Sijankhadk65/orio_dev/orio-jetson/docs/checkerboard_9x6_24mm_a4.pdf

100 mm reference - measure this after printing; if it is not 100 mm, the print was rescaled and every distance will be wrong

Orio stereo calibration target - 10x7 squares = 9x6 inner corners - nominal square 24 mm - print A4 landscape at 100% / actual size, no fit-to-page tools/calibrate_stereo.py
