Sijankhadk65/orio_dev/orio-jetson/grocery-inventory.md

Lay's Classic Potato Chips are $3.49, in aisle 7 with the other snacks, and currently in stock.

Doritos Nacho Cheese chips are $4.29, in aisle 7, and currently in stock.

Pretzel twists are $2.99, in aisle 7, and currently in stock.

Microwave popcorn, a 6-pack, is $3.19, in aisle 7, and currently in stock.

Coca-Cola, a 12-pack of cans, is $5.99, in aisle 7, and currently in stock.

Bottled water, a 24-pack, is $4.49, in aisle 7, and currently in stock.

Orange juice, a half-gallon, is $3.79, in the dairy section in aisle 1, and currently in stock.

Ground coffee, a 12oz bag, is $7.99, in aisle 6 with the other dry goods, and currently in stock.

Whole milk, one gallon, is $3.29, in aisle 1 with the dairy, and currently in stock.

Large eggs, a dozen, are $2.99, in aisle 1 with the dairy, and currently in stock.

Cheddar cheese, an 8oz block, is $4.49, in aisle 1 with the dairy, and currently in stock.

Butter, a 1lb pack, is $4.99, in aisle 1 with the dairy, and currently in stock.

Bananas are $0.59 a pound, in the produce section near the entrance, and currently in stock.

Apples are $1.29 a pound, in the produce section near the entrance, and currently in stock.

Tomatoes are $1.99 a pound, in the produce section near the entrance, and currently in stock.

Avocados are $1.49 each, in the produce section near the entrance, and currently in stock.

White sandwich bread is $2.49 a loaf, in the bakery section at the front of the store, and currently in stock.

Bagels, a 6-pack, are $3.99, in the bakery section at the front of the store, and currently in stock.

Croissants, a 6-pack, are $4.29, in the bakery section at the front of the store, and currently in stock.

Canned corn is $0.99 a can, in aisle 4 with the other canned goods, and currently in stock.

Tomato soup is $1.29 a can, in aisle 4 with the other canned goods, and currently in stock.

Black beans are $1.09 a can, in aisle 4 with the other canned goods, and currently in stock.

Paper towels, a 6-roll pack, are $6.99, in aisle 8 with household supplies, and currently in stock.

Dish soap is $3.49 a bottle, in aisle 8 with household supplies, and currently in stock.

Laundry detergent is $9.99 a bottle, in aisle 8 with household supplies, and currently in stock.

Frozen pizza is $5.99 each, in aisle 2 with the frozen foods, and currently in stock.

Ice cream, a 1-quart tub, is $4.99, in aisle 2 with the frozen foods, and currently in stock.

Frozen mixed vegetables, a 1lb bag, are $2.49, in aisle 3 with the frozen foods, and currently in stock.

Rice, a 5lb bag, is $6.49, in aisle 5 with the other dry goods, and currently in stock.

Pasta, a 1lb box, is $1.79, in aisle 5 with the other dry goods, and currently in stock.
