Sijankhadk65/orio_dev/hardware/orio-carrier/conv7v4.kicad_sch

## KiCad design hardware/orio-carrier/conv7v4.kicad_sch (2026-09-13, an earlier design)

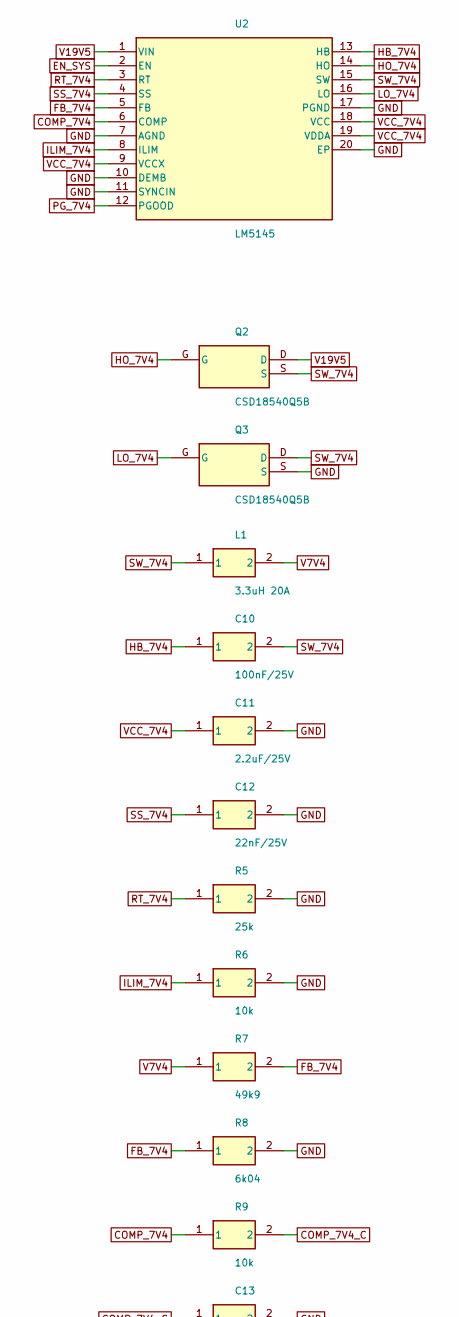
[picture p1: schematic conv7v4.kicad_sch, part in row 1, column 1]

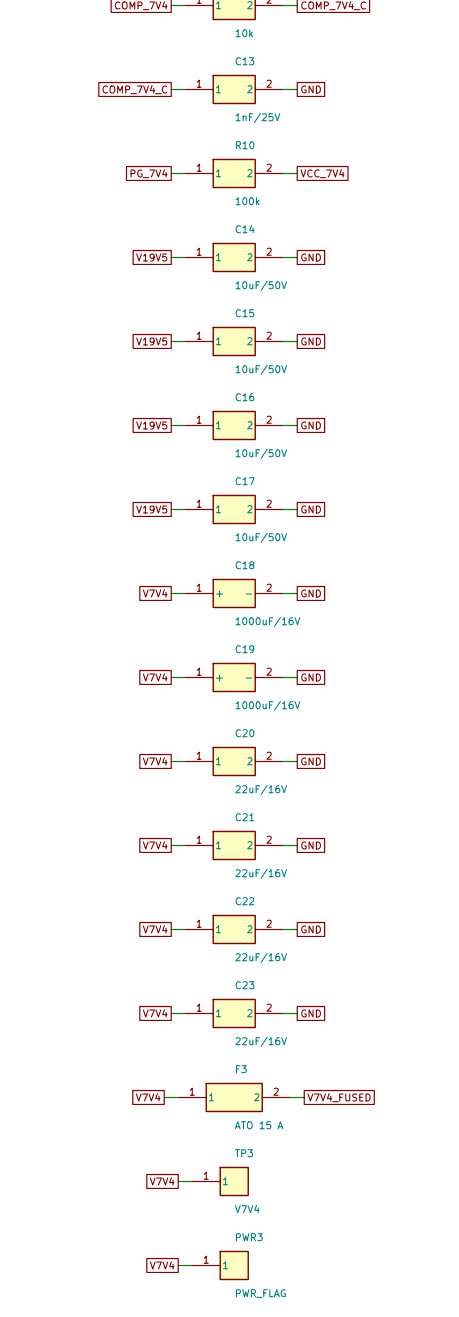
[picture p2: schematic conv7v4.kicad_sch, part in row 2, column 1]

Parts:
C10: 100nF/25V; C_0805_2012Metric
C11: 2.2uF/25V; C_0805_2012Metric
C12: 22nF/25V; C_0805_2012Metric
C13: 1nF/25V; C_0805_2012Metric
C14, C15, C16, C17: 10uF/50V; C_1210_3225Metric
C18, C19: 1000uF/16V; CP_Radial_D12.5mm_P5.00mm
C20, C21, C22, C23: 22uF/16V; C_1210_3225Metric
F3: ATO 15 A; PinHeader_1x02_P2.54mm_Vertical
L1: 3.3uH 20A; L_Bourns_SRP1265A
PWR3: PWR_FLAG
Q2, Q3: CSD18540Q5B; TO-263-2
R5: 25k; R_0805_2012Metric
R6, R9: 10k; R_0805_2012Metric
R7: 49k9; R_0805_2012Metric
R8: 6k04; R_0805_2012Metric
R10: 100k; R_0805_2012Metric
TP3: V7V4; TestPoint_Pad_D2.0mm
U2: LM5145; VQFN-24-1EP_4x4mm_P0.5mm_EP2.6x2.6mm

Connections:
COMP_7V4: R9.1, U2.6 (COMP)
COMP_7V4_C: C13.1, R9.2
EN_SYS: U2.2 (EN)
FB_7V4: R7.2, R8.1, U2.5 (FB)
GND: C11.2, C12.2, C13.2, C14.2, C15.2, C16.2, C17.2, C18.2 (-), C19.2 (-), C20.2, C21.2, C22.2, C23.2, Q3.S, R5.2, R6.2, R8.2, U2.7 (AGND), U2.10 (DEMB), U2.11 (SYNCIN), U2.17 (PGND), U2.20 (EP)
HB_7V4: C10.1, U2.13 (HB)
HO_7V4: Q2.G, U2.14 (HO)
ILIM_7V4: R6.1, U2.8 (ILIM)
LO_7V4: Q3.G, U2.16 (LO)
PG_7V4: R10.1, U2.12 (PGOOD)
RT_7V4: R5.1, U2.3 (RT)
SS_7V4: C12.1, U2.4 (SS)
SW_7V4: C10.2, L1.1, Q2.S, Q3.D, U2.15 (SW)
V7V4: C18.1 (+), C19.1 (+), C20.1, C21.1, C22.1, C23.1, F3.1, L1.2, PWR3.1, R7.1, TP3.1
V7V4_FUSED: F3.2
V19V5: C14.1, C15.1, C16.1, C17.1, Q2.D, U2.1 (VIN)
VCC_7V4: C11.1, R10.2, U2.9 (VCCX), U2.18 (VCC), U2.19 (VDDA)
