Sijankhadk65/orio_dev/hardware/orio-carrier/conv12_5.kicad_sch

## KiCad design hardware/orio-carrier/conv12_5.kicad_sch (2026-09-13, an earlier design)

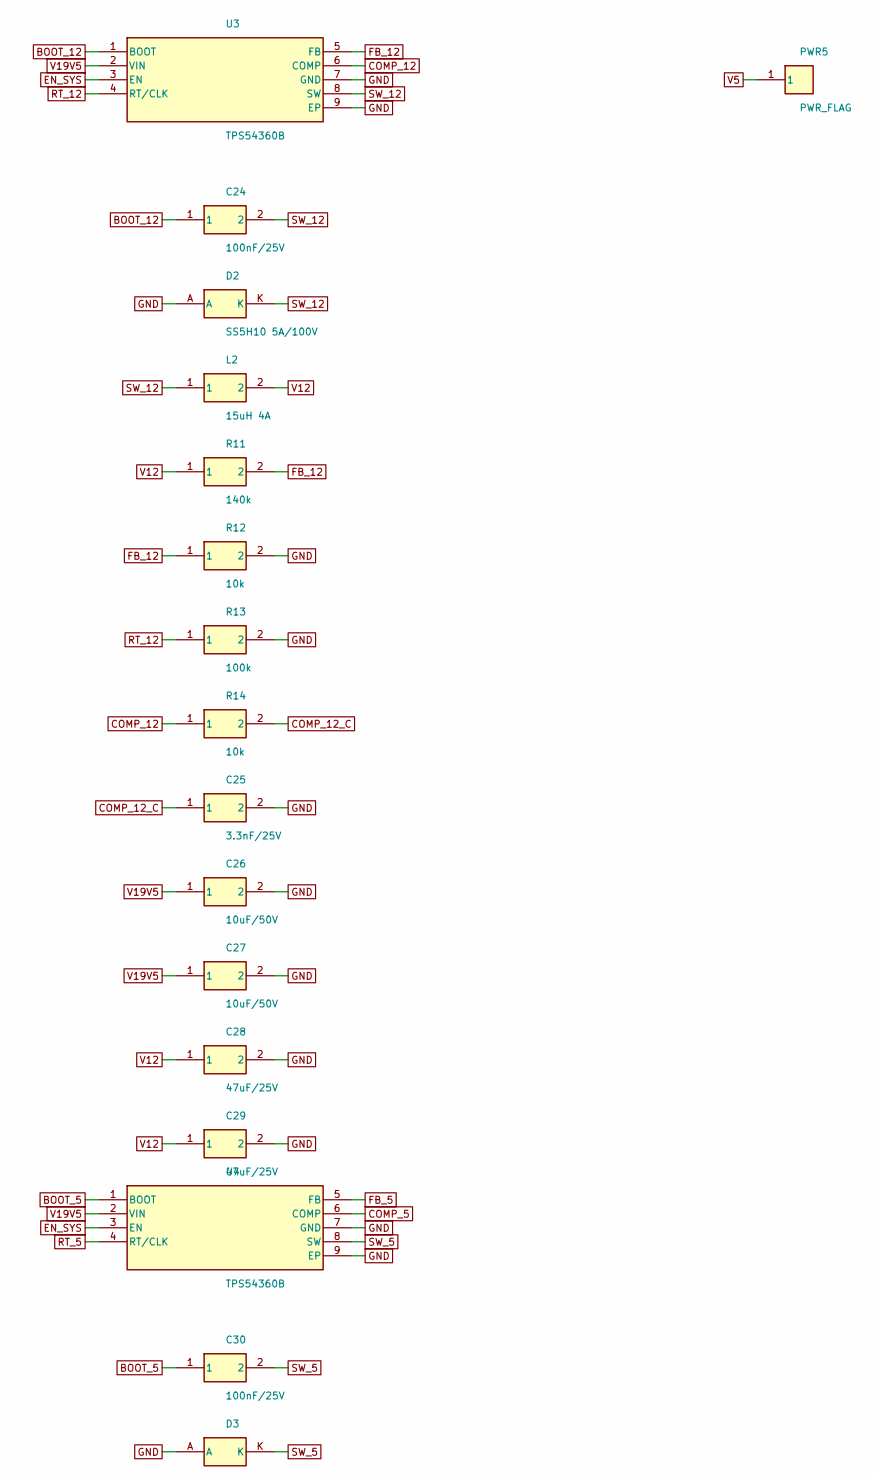
[picture p3: schematic conv12_5.kicad_sch, part in row 1, column 1]

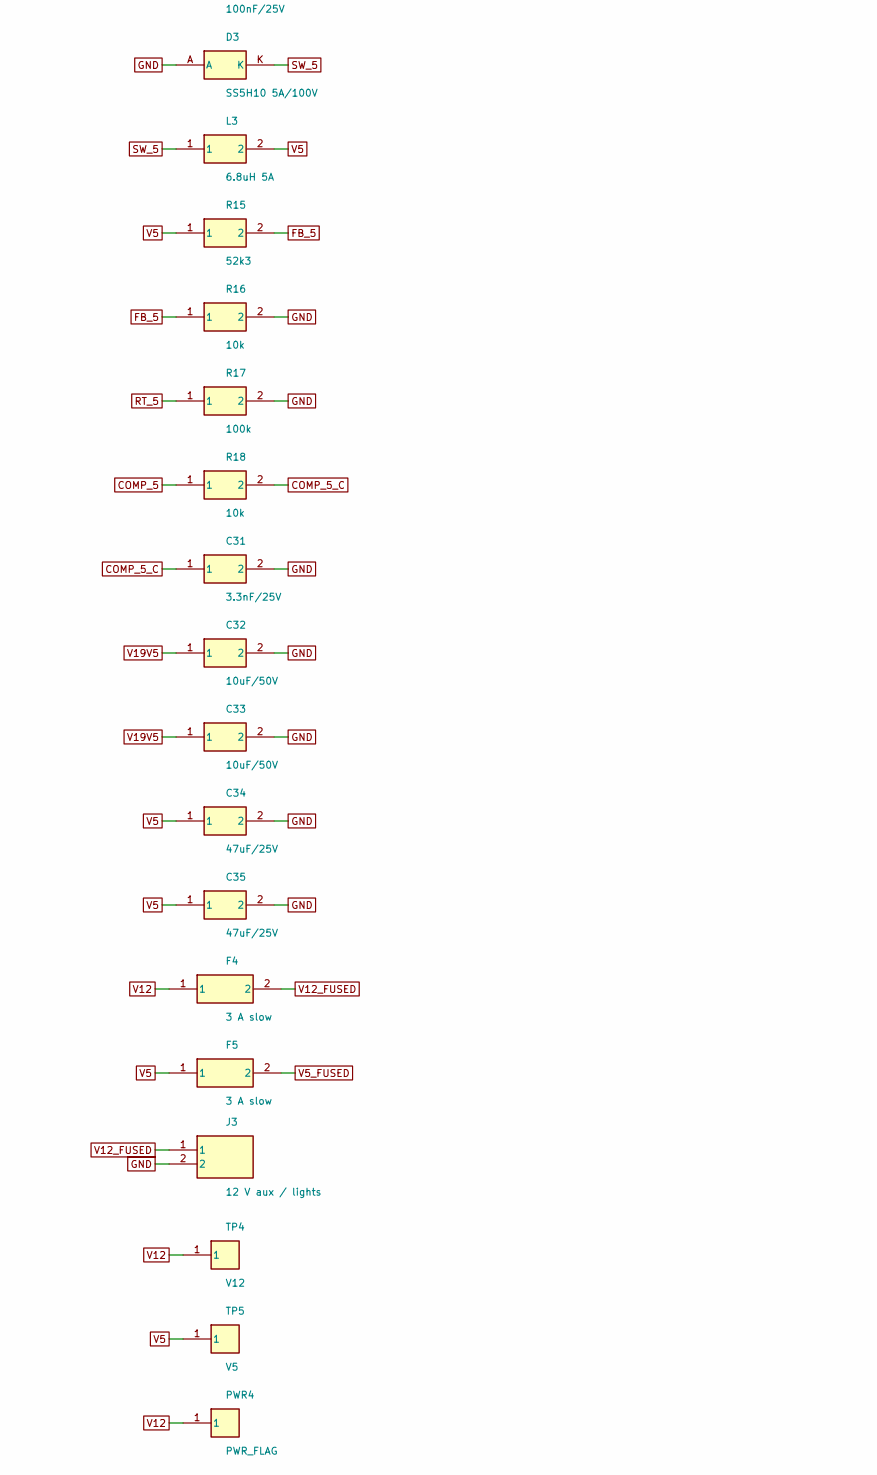
[picture p4: schematic conv12_5.kicad_sch, part in row 2, column 1]

Parts:
C24, C30: 100nF/25V; C_0805_2012Metric
C25, C31: 3.3nF/25V; C_0805_2012Metric
C26, C27, C32, C33: 10uF/50V; C_1210_3225Metric
C28, C29, C34, C35: 47uF/25V; C_1210_3225Metric
D2, D3: SS5H10 5A/100V; D_SMC
F4, F5: 3 A slow; Fuse_1812_4532Metric
J3: 12 V aux / lights; TerminalBlock_Phoenix_MKDS-1,5-2_1x02_P5.00mm_Horizontal
L2: 15uH 4A; L_Bourns-SRN6045TA
L3: 6.8uH 5A; L_Bourns-SRN6045TA
PWR4, PWR5: PWR_FLAG
R11: 140k; R_0805_2012Metric
R12, R14, R16, R18: 10k; R_0805_2012Metric
R13, R17: 100k; R_0805_2012Metric
R15: 52k3; R_0805_2012Metric
TP4: V12; TestPoint_Pad_D2.0mm
TP5: V5; TestPoint_Pad_D2.0mm
U3, U4: TPS54360B; SOIC-8-1EP_3.9x4.9mm_P1.27mm_EP2.29x3.0mm

Connections:
BOOT_5: C30.1, U4.1 (BOOT)
BOOT_12: C24.1, U3.1 (BOOT)
COMP_5: R18.1, U4.6 (COMP)
COMP_5_C: C31.1, R18.2
COMP_12: R14.1, U3.6 (COMP)
COMP_12_C: C25.1, R14.2
EN_SYS: U3.3 (EN), U4.3 (EN)
FB_5: R15.2, R16.1, U4.5 (FB)
FB_12: R11.2, R12.1, U3.5 (FB)
GND: C25.2, C26.2, C27.2, C28.2, C29.2, C31.2, C32.2, C33.2, C34.2, C35.2, D2.A, D3.A, J3.2, R12.2, R13.2, R16.2, R17.2, U3.7 (GND), U3.9 (EP), U4.7 (GND), U4.9 (EP)
RT_5: R17.1, U4.4 (RT/CLK)
RT_12: R13.1, U3.4 (RT/CLK)
SW_5: C30.2, D3.K, L3.1, U4.8 (SW)
SW_12: C24.2, D2.K, L2.1, U3.8 (SW)
V5: C34.1, C35.1, F5.1, L3.2, PWR5.1, R15.1, TP5.1
V5_FUSED: F5.2
V12: C28.1, C29.1, F4.1, L2.2, PWR4.1, R11.1, TP4.1
V12_FUSED: F4.2, J3.1
V19V5: C26.1, C27.1, C32.1, C33.1, U3.2 (VIN), U4.2 (VIN)
