Sijankhadk65/orio_dev/hardware/orio-carrier/drivetrain.kicad_sch

## KiCad design hardware/orio-carrier/drivetrain.kicad_sch (2026-09-13, an earlier design)

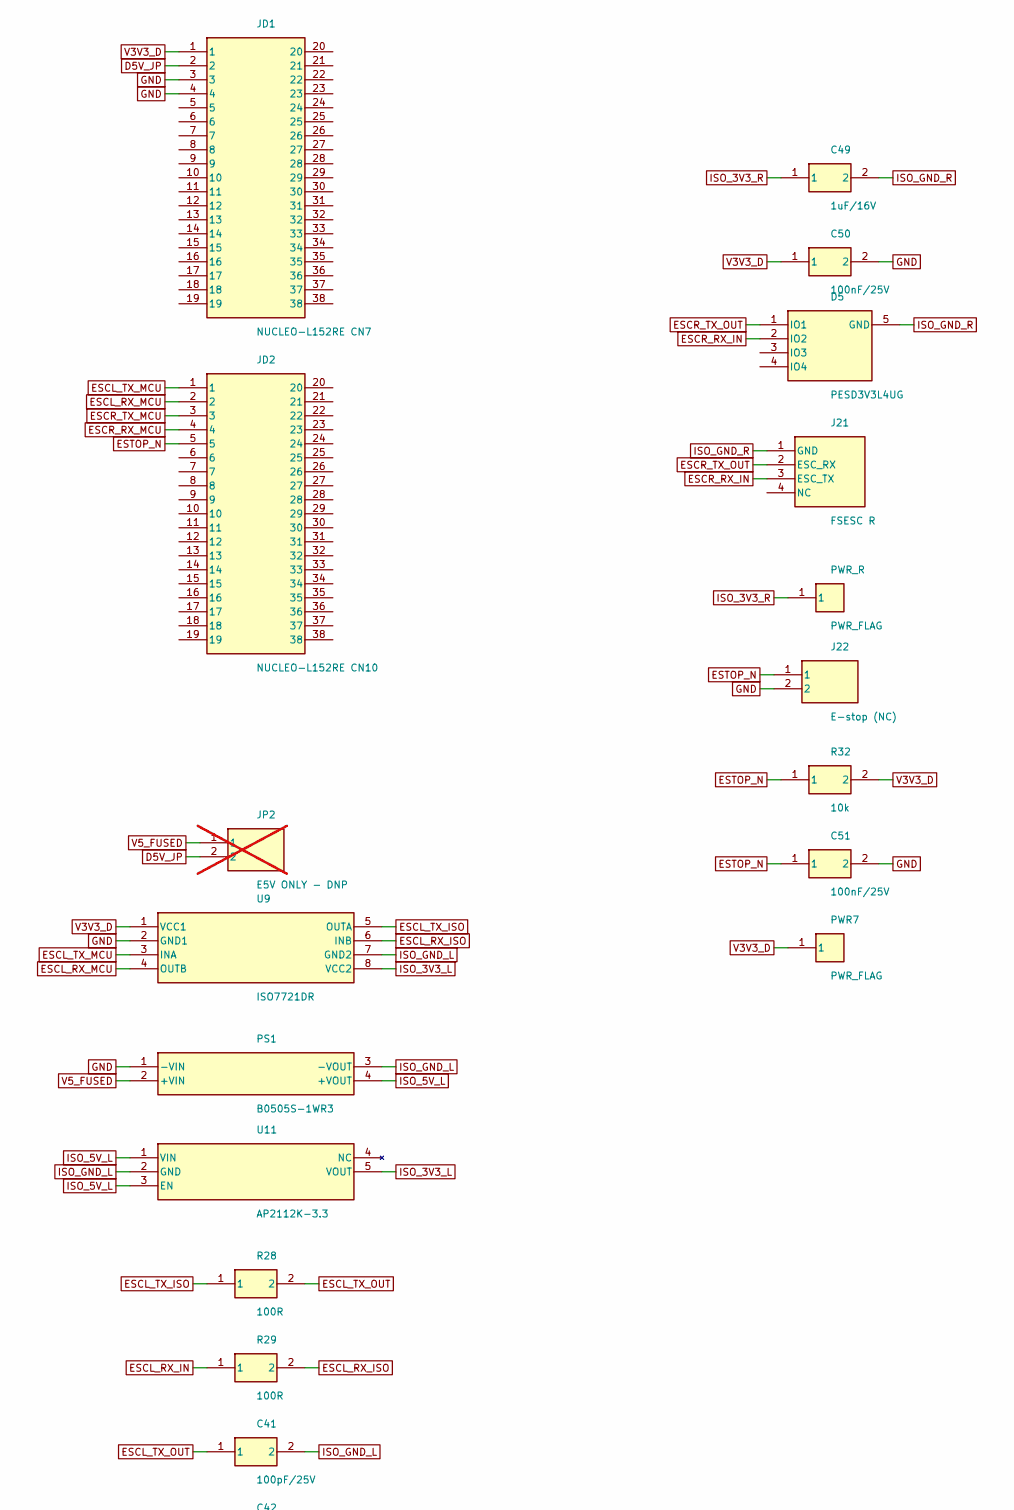
[picture p5: schematic drivetrain.kicad_sch, part in row 1, column 1]

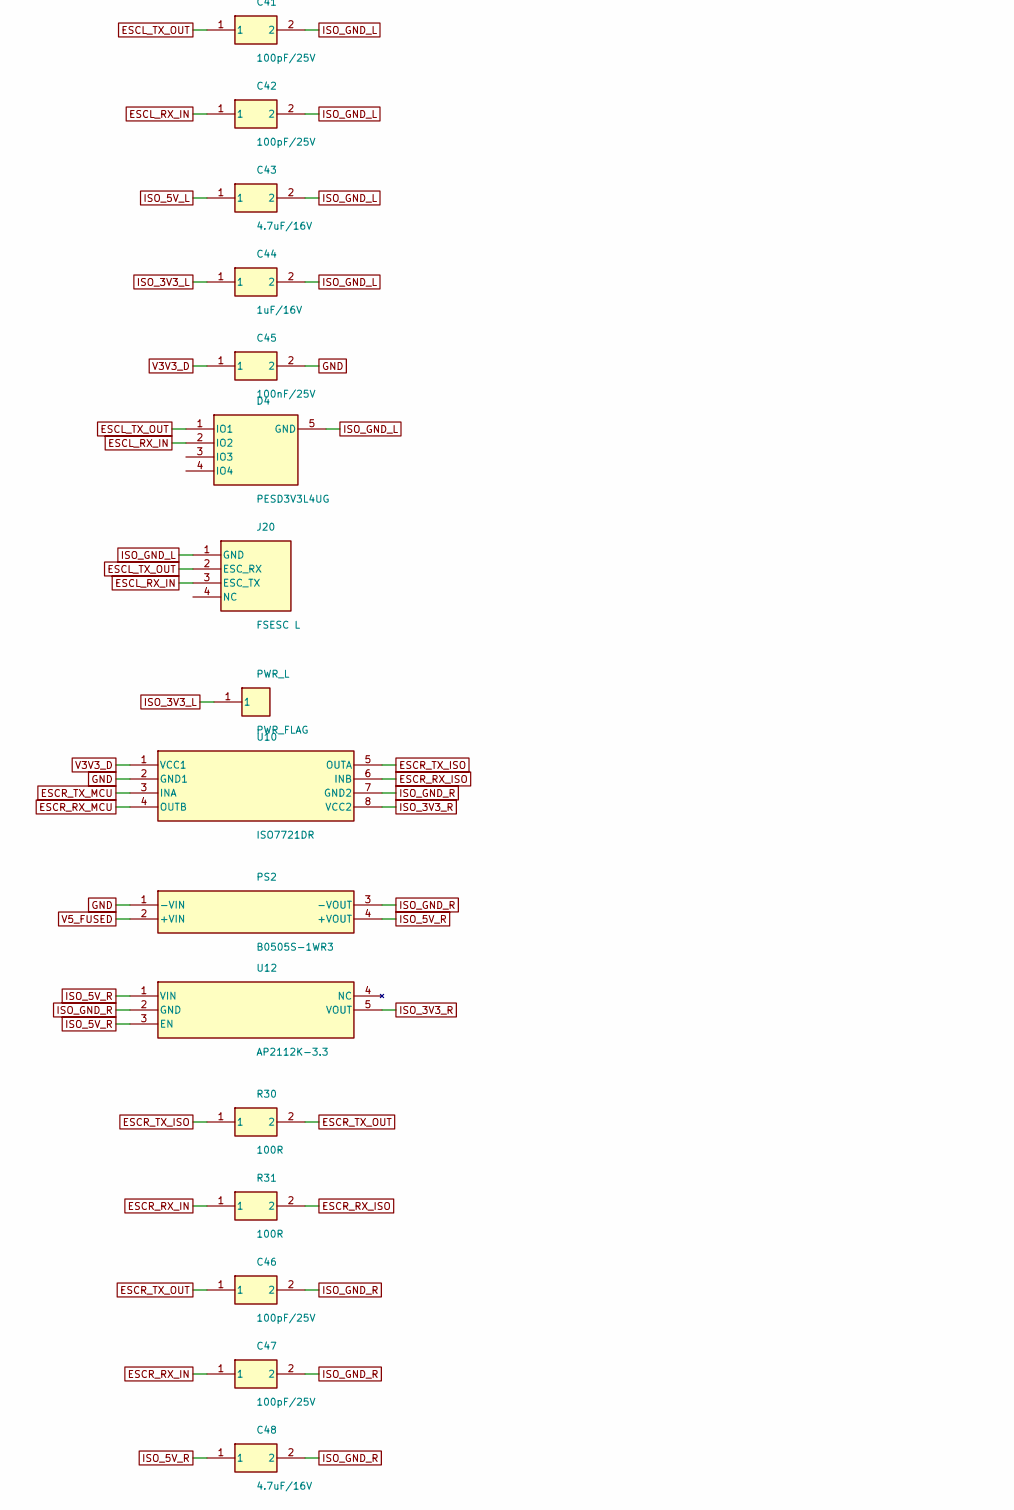
[picture p6: schematic drivetrain.kicad_sch, part in row 2, column 1]

Parts:
C41, C42, C46, C47: 100pF/25V; C_0805_2012Metric
C43, C48: 4.7uF/16V; C_0805_2012Metric
C44, C49: 1uF/16V; C_0805_2012Metric
C45, C50, C51: 100nF/25V; C_0805_2012Metric
D4, D5: PESD3V3L4UG; SOT-23-6
J20: FSESC L; JST_XH_B4B-XH-A_1x04_P2.50mm_Vertical
J21: FSESC R; JST_XH_B4B-XH-A_1x04_P2.50mm_Vertical
J22: E-stop (NC); PinHeader_1x02_P2.54mm_Vertical
JD1: NUCLEO-L152RE CN7; PinSocket_2x19_P2.54mm_Vertical
JD2: NUCLEO-L152RE CN10; PinSocket_2x19_P2.54mm_Vertical
JP2: E5V ONLY - DNP; PinHeader_1x02_P2.54mm_Vertical; not fitted
PS1, PS2: B0505S-1WR3; Converter_DCDC_MORNSUN_B0505S-1WR3_SIP
PWR7: PWR_FLAG
PWR_L: PWR_FLAG
PWR_R: PWR_FLAG
R28, R29, R30, R31: 100R; R_0805_2012Metric
R32: 10k; R_0805_2012Metric
U9, U10: ISO7721DR; SOIC-8_3.9x4.9mm_P1.27mm
U11, U12: AP2112K-3.3; SOT-23-5

Connections:
D5V_JP: JD1.2, JP2.2
ESCL_RX_IN: C42.1, D4.2 (IO2), J20.3 (ESC_TX), R29.1
ESCL_RX_ISO: R29.2, U9.6 (INB)
ESCL_RX_MCU: JD2.2, U9.4 (OUTB)
ESCL_TX_ISO: R28.1, U9.5 (OUTA)
ESCL_TX_MCU: JD2.1, U9.3 (INA)
ESCL_TX_OUT: C41.1, D4.1 (IO1), J20.2 (ESC_RX), R28.2
ESCR_RX_IN: C47.1, D5.2 (IO2), J21.3 (ESC_TX), R31.1
ESCR_RX_ISO: R31.2, U10.6 (INB)
ESCR_RX_MCU: JD2.4, U10.4 (OUTB)
ESCR_TX_ISO: R30.1, U10.5 (OUTA)
ESCR_TX_MCU: JD2.3, U10.3 (INA)
ESCR_TX_OUT: C46.1, D5.1 (IO1), J21.2 (ESC_RX), R30.2
ESTOP_N: C51.1, J22.1, JD2.5, R32.1
GND: C45.2, C50.2, C51.2, J22.2, JD1.3, JD1.4, PS1.1 (-VIN), PS2.1 (-VIN), U9.2 (GND1), U10.2 (GND1)
ISO_3V3_L: C44.1, PWR_L.1, U9.8 (VCC2), U11.5 (VOUT)
ISO_3V3_R: C49.1, PWR_R.1, U10.8 (VCC2), U12.5 (VOUT)
ISO_5V_L: C43.1, PS1.4 (+VOUT), U11.1 (VIN), U11.3 (EN)
ISO_5V_R: C48.1, PS2.4 (+VOUT), U12.1 (VIN), U12.3 (EN)
ISO_GND_L: C41.2, C42.2, C43.2, C44.2, D4.5 (GND), J20.1 (GND), PS1.3 (-VOUT), U9.7 (GND2), U11.2 (GND)
ISO_GND_R: C46.2, C47.2, C48.2, C49.2, D5.5 (GND), J21.1 (GND), PS2.3 (-VOUT), U10.7 (GND2), U12.2 (GND)
V3V3_D: C45.1, C50.1, JD1.1, PWR7.1, R32.2, U9.1 (VCC1), U10.1 (VCC1)
V5_FUSED: JP2.1, PS1.2 (+VIN), PS2.2 (+VIN)
