Sijankhadk65/orio_dev/hardware/orio-carrier/motion.kicad_sch

## KiCad design hardware/orio-carrier/motion.kicad_sch (2026-09-13)

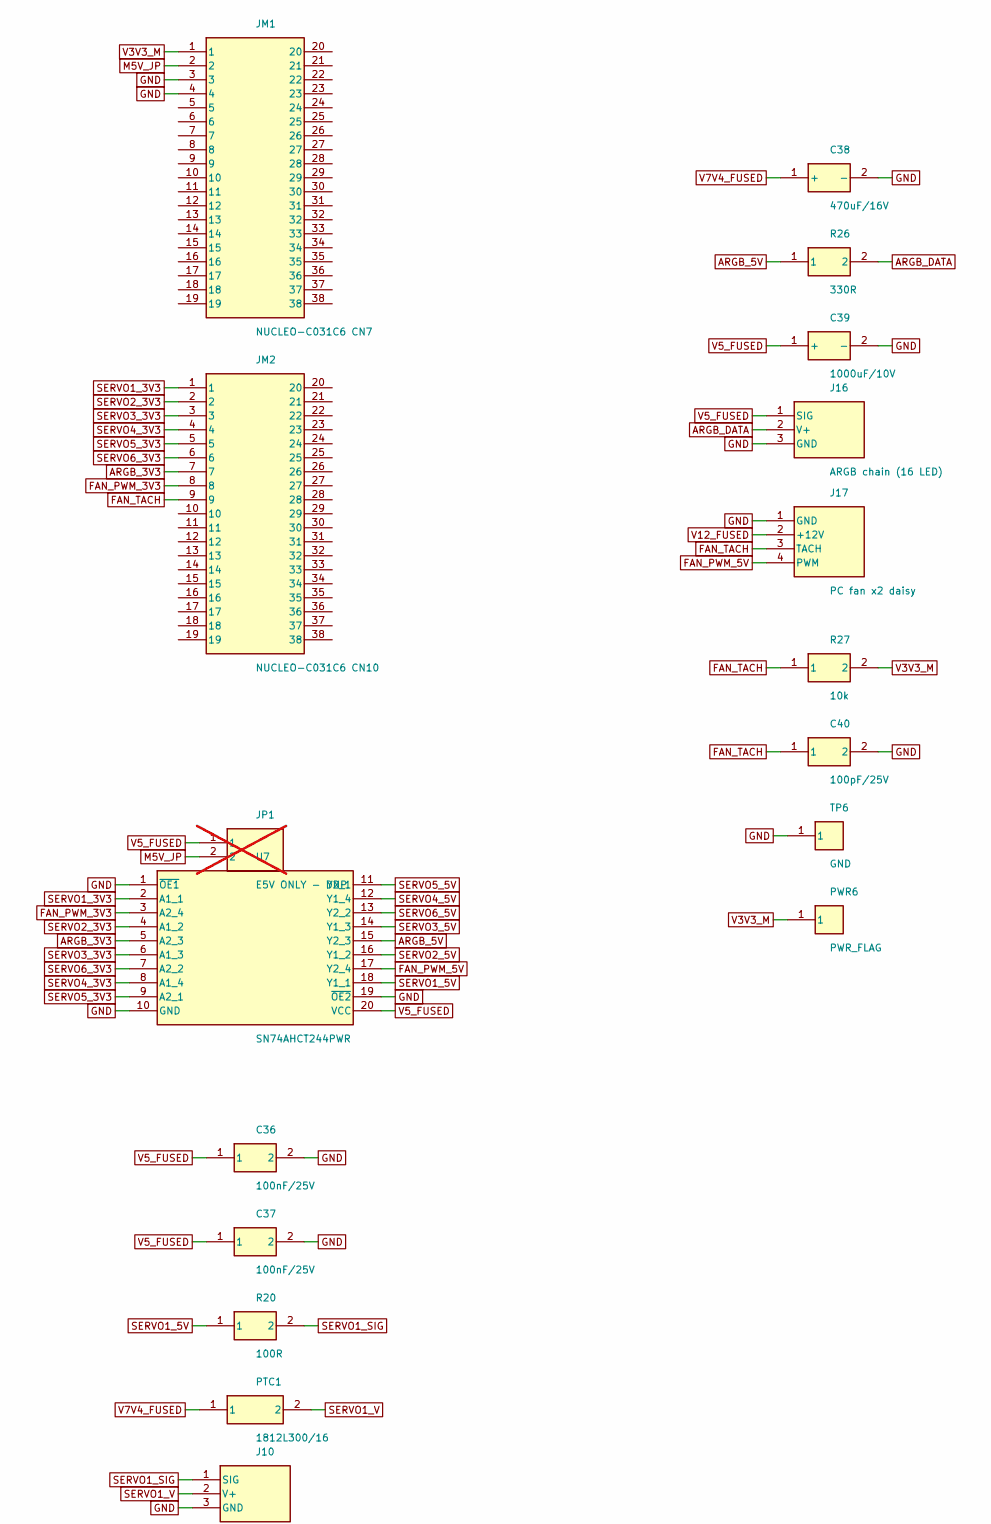
[picture p7: schematic motion.kicad_sch, part in row 1, column 1]

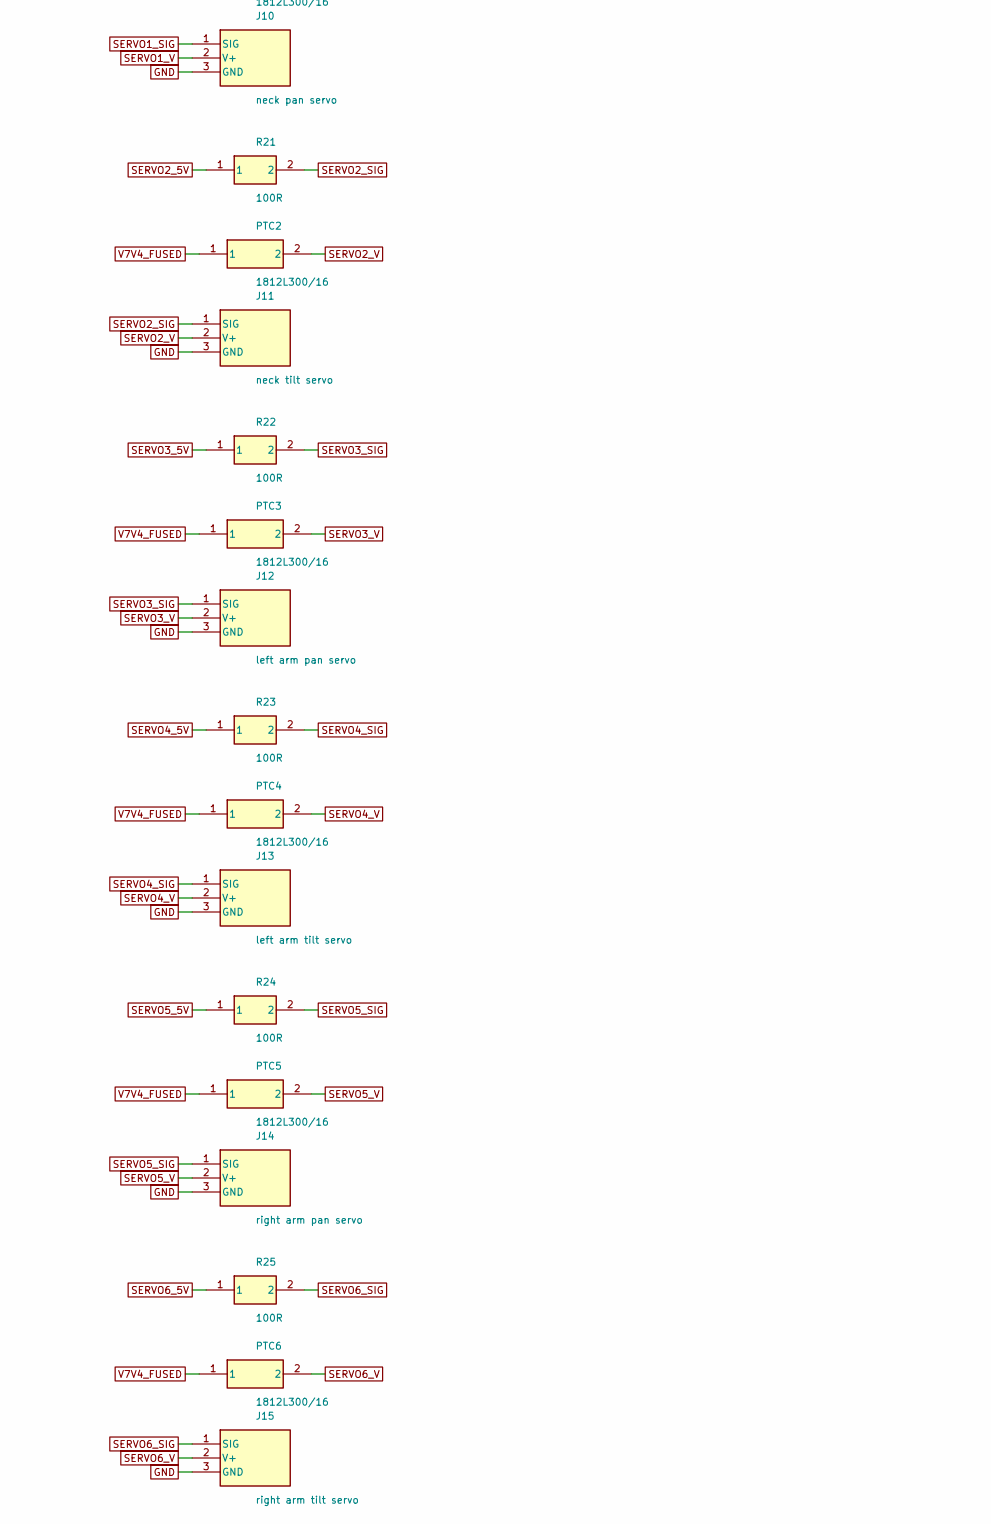
[picture p8: schematic motion.kicad_sch, part in row 2, column 1]

Parts:
C36, C37: 100nF/25V; C_0805_2012Metric
C38: 470uF/16V; CP_Radial_D10.0mm_P5.00mm
C39: 1000uF/10V; CP_Radial_D12.5mm_P5.00mm
C40: 100pF/25V; C_0805_2012Metric
J10: neck pan servo; PinHeader_1x03_P2.54mm_Vertical
J11: neck tilt servo; PinHeader_1x03_P2.54mm_Vertical
J12: left arm pan servo; PinHeader_1x03_P2.54mm_Vertical
J13: left arm tilt servo; PinHeader_1x03_P2.54mm_Vertical
J14: right arm pan servo; PinHeader_1x03_P2.54mm_Vertical
J15: right arm tilt servo; PinHeader_1x03_P2.54mm_Vertical
J16: ARGB chain (16 LED); PinHeader_1x03_P2.54mm_Vertical
J17: PC fan x2 daisy; PinHeader_1x04_P2.54mm_Vertical
JM1: NUCLEO-C031C6 CN7; PinSocket_2x19_P2.54mm_Vertical
JM2: NUCLEO-C031C6 CN10; PinSocket_2x19_P2.54mm_Vertical
JP1: E5V ONLY - DNP; PinHeader_1x02_P2.54mm_Vertical; not fitted
PTC1, PTC2, PTC3, PTC4, PTC5, PTC6: 1812L300/16; R_1812_4532Metric
PWR6: PWR_FLAG
R20, R21, R22, R23, R24, R25: 100R; R_0805_2012Metric
R26: 330R; R_0805_2012Metric
R27: 10k; R_0805_2012Metric
TP6: GND; TestPoint_Pad_D2.0mm
U7: SN74AHCT244PWR; TSSOP-20_4.4x6.5mm_P0.65mm

Connections:
ARGB_3V3: JM2.7, U7.5 (A2_3)
ARGB_5V: R26.1, U7.15 (Y2_3)
ARGB_DATA: J16.2 (V+), R26.2
FAN_PWM_3V3: JM2.8, U7.3 (A2_4)
FAN_PWM_5V: J17.4 (PWM), U7.17 (Y2_4)
FAN_TACH: C40.1, J17.3 (TACH), JM2.9, R27.1
GND: C36.2, C37.2, C38.2 (-), C39.2 (-), C40.2, J10.3 (GND), J11.3 (GND), J12.3 (GND), J13.3 (GND), J14.3 (GND), J15.3 (GND), J16.3 (GND), J17.1 (GND), JM1.3, JM1.4, TP6.1, U7.1 (~OE1), U7.10 (GND), U7.19 (~OE2)
M5V_JP: JM1.2, JP1.2
SERVO1_3V3: JM2.1, U7.2 (A1_1)
SERVO1_5V: R20.1, U7.18 (Y1_1)
SERVO1_SIG: J10.1 (SIG), R20.2
SERVO1_V: J10.2 (V+), PTC1.2
SERVO2_3V3: JM2.2, U7.4 (A1_2)
SERVO2_5V: R21.1, U7.16 (Y1_2)
SERVO2_SIG: J11.1 (SIG), R21.2
SERVO2_V: J11.2 (V+), PTC2.2
SERVO3_3V3: JM2.3, U7.6 (A1_3)
SERVO3_5V: R22.1, U7.14 (Y1_3)
SERVO3_SIG: J12.1 (SIG), R22.2
SERVO3_V: J12.2 (V+), PTC3.2
SERVO4_3V3: JM2.4, U7.8 (A1_4)
SERVO4_5V: R23.1, U7.12 (Y1_4)
SERVO4_SIG: J13.1 (SIG), R23.2
SERVO4_V: J13.2 (V+), PTC4.2
SERVO5_3V3: JM2.5, U7.9 (A2_1)
SERVO5_5V: R24.1, U7.11 (Y2_1)
SERVO5_SIG: J14.1 (SIG), R24.2
SERVO5_V: J14.2 (V+), PTC5.2
SERVO6_3V3: JM2.6, U7.7 (A2_2)
SERVO6_5V: R25.1, U7.13 (Y2_2)
SERVO6_SIG: J15.1 (SIG), R25.2
SERVO6_V: J15.2 (V+), PTC6.2
V3V3_M: JM1.1, PWR6.1, R27.2
V5_FUSED: C36.1, C37.1, C39.1 (+), J16.1 (SIG), JP1.1, U7.20 (VCC)
V7V4_FUSED: C38.1 (+), PTC1.1, PTC2.1, PTC3.1, PTC4.1, PTC5.1, PTC6.1
V12_FUSED: J17.2 (+12V)
