Sijankhadk65/orio_dev/hardware/orio-carrier/power.kicad_sch

## KiCad design hardware/orio-carrier/power.kicad_sch (2026-09-13, an earlier design)

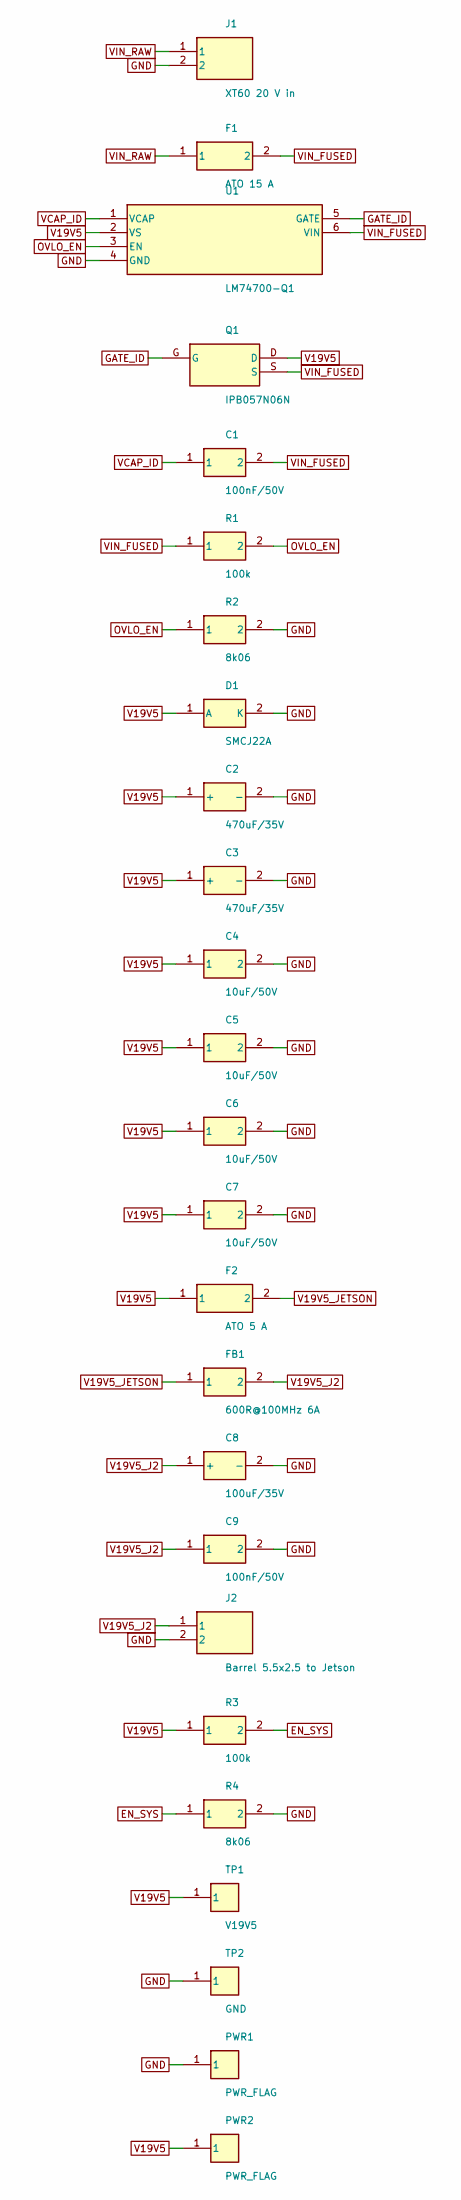
[picture p9: schematic power.kicad_sch]

Parts:
C1, C9: 100nF/50V; C_0805_2012Metric
C2, C3: 470uF/35V; CP_Radial_D12.5mm_P5.00mm
C4, C5, C6, C7: 10uF/50V; C_1210_3225Metric
C8: 100uF/35V; CP_Radial_D10.0mm_P5.00mm
D1: SMCJ22A; D_SMC
F1: ATO 15 A; PinHeader_1x02_P2.54mm_Vertical
F2: ATO 5 A; PinHeader_1x02_P2.54mm_Vertical
FB1: 600R@100MHz 6A; L_1812_4532Metric
J1: XT60 20 V in; SolderWirePad_1x02_P5.08mm_Drill1.5mm
J2: Barrel 5.5x2.5 to Jetson; BarrelJack_Horizontal
PWR1, PWR2: PWR_FLAG
Q1: IPB057N06N; TO-263-2
R1, R3: 100k; R_0805_2012Metric
R2, R4: 8k06; R_0805_2012Metric
TP1: V19V5; TestPoint_Pad_D2.0mm
TP2: GND; TestPoint_Pad_D2.0mm
U1: LM74700-Q1; SOT-23-6

Connections:
EN_SYS: R3.2, R4.1
GATE_ID: Q1.G, U1.5 (GATE)
GND: C2.2 (-), C3.2 (-), C4.2, C5.2, C6.2, C7.2, C8.2 (-), C9.2, D1.2 (K), J1.2, J2.2, PWR1.1, R2.2, R4.2, TP2.1, U1.4 (GND)
OVLO_EN: R1.2, R2.1, U1.3 (EN)
V19V5: C2.1 (+), C3.1 (+), C4.1, C5.1, C6.1, C7.1, D1.1 (A), F2.1, PWR2.1, Q1.D, R3.1, TP1.1, U1.2 (VS)
V19V5_J2: C8.1 (+), C9.1, FB1.2, J2.1
V19V5_JETSON: F2.2, FB1.1
VCAP_ID: C1.1, U1.1 (VCAP)
VIN_FUSED: C1.2, F1.2, Q1.S, R1.1, U1.6 (VIN)
VIN_RAW: F1.1, J1.1
