Sijankhadk65/orio_dev/orio-stm-motion/Core/Src/main.c

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
/* Includes ------------------------------------------------------------------*/
#include "main.h"

/* USER CODE BEGIN Includes */
#include "protocol.h"
#include "servo_joint.h"
#include "fan.h"
#include "argb.h"
/* USER CODE END Includes */


TIM_HandleTypeDef htim1;
TIM_HandleTypeDef htim3;
TIM_HandleTypeDef htim14;
TIM_HandleTypeDef htim16;
DMA_HandleTypeDef hdma_tim16_ch1;

UART_HandleTypeDef huart2;

/* USER CODE BEGIN PV */
static ServoJoint_t s_neckJoint;     /* pan (TIM3_CH1/PA6) + tilt (TIM3_CH2/PA7) */
static ServoJoint_t s_leftArmJoint;  /* pan (TIM3_CH3/PB0) + tilt (TIM3_CH4/PB1) */
static ServoJoint_t s_rightArmJoint; /* pan (TIM1_CH1/PA8) + tilt (TIM1_CH2/PA9) */
static uint32_t s_lastServoTick;     /* HAL tick the joint ramps were last stepped at */
/* USER CODE END PV */

void SystemClock_Config(void);
static void MX_GPIO_Init(void);
static void MX_DMA_Init(void);
static void MX_USART2_UART_Init(void);
static void MX_TIM1_Init(void);
static void MX_TIM3_Init(void);
static void MX_TIM14_Init(void);
static void MX_TIM16_Init(void);
/**
  * @brief  The application entry point.
  * @retval int
  */
int main(void)
{

  /* MCU Configuration--------------------------------------------------------*/

  /* Reset of all peripherals, Initializes the Flash interface and the Systick. */
  HAL_Init();

  /* Configure the system clock */
  SystemClock_Config();

  /* Initialize all configured peripherals */
  MX_GPIO_Init();
  MX_DMA_Init();
  MX_USART2_UART_Init();
  MX_TIM1_Init();
  MX_TIM3_Init();
  MX_TIM14_Init();
  MX_TIM16_Init();
  /* USER CODE BEGIN 2 */
  ServoJoint_Init(&s_neckJoint, JOINT_POS_NECK, &htim3, TIM_CHANNEL_1, &htim3, TIM_CHANNEL_2);
  ServoJoint_Init(&s_leftArmJoint, JOINT_POS_LEFT_ARM, &htim3, TIM_CHANNEL_3, &htim3, TIM_CHANNEL_4);
  ServoJoint_Init(&s_rightArmJoint, JOINT_POS_RIGHT_ARM, &htim1, TIM_CHANNEL_1, &htim1, TIM_CHANNEL_2);
  Fan_Init(&htim14, TIM_CHANNEL_1);
  ARGB_Init(&htim16, TIM_CHANNEL_1);
  Protocol_BindJoint(JOINT_POS_NECK, &s_neckJoint); /* bind before Protocol_Init() so it can hold the joint stopped */
  Protocol_BindJoint(JOINT_POS_LEFT_ARM, &s_leftArmJoint);
  Protocol_BindJoint(JOINT_POS_RIGHT_ARM, &s_rightArmJoint);
  Protocol_Init(&huart2);
  s_lastServoTick = HAL_GetTick();
  /* USER CODE END 2 */

  /* Infinite loop */
  /* USER CODE BEGIN WHILE */
  while (1)
  {
    Protocol_Process();
    /* USER CODE END WHILE */

    /* USER CODE BEGIN 3 */
    /* Step every joint's ramp toward its target (see ServoJoint_Update()).
     * This loop spins far faster than the 1 ms HAL tick, so most passes see
     * elapsed == 0. Advancing s_lastServoTick only on a non-zero elapsed is
     * what makes that safe: resetting it every pass would discard the
     * sub-millisecond remainder each time and the ramp would never advance. */
    uint32_t now = HAL_GetTick();
    uint32_t elapsed_ms = now - s_lastServoTick;
    if (elapsed_ms > 0u)
    {
      s_lastServoTick = now;
      ServoJoint_Update(&s_neckJoint, elapsed_ms);
      ServoJoint_Update(&s_leftArmJoint, elapsed_ms);
      ServoJoint_Update(&s_rightArmJoint, elapsed_ms);
    }
  }
  /* USER CODE END 3 */
}

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
/* USER CODE BEGIN 4 */
/**
  * @brief  UART Rx-complete callback: forwards the received byte to the protocol layer.
  * @param  huart UART handle for which the receive completed.
  * @retval None
  */
void HAL_UART_RxCpltCallback(UART_HandleTypeDef *huart)
{
  Protocol_UART_RxCpltCallback(huart);
}
/* USER CODE END 4 */
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
