Sijankhadk65/orio_dev/orio-stm-motion/orio-stm-motion.ioc

Mcu.UserName=STM32C031C6Tx
PA0.GPIO_Label=ARGB_DATA
PA0.Signal=S_TIM16_CH1
PA13.GPIO_Label=DEBUG_SWDIO
PA13.Signal=DEBUG_SWDIO
PA14-BOOT0.GPIO_Label=DEBUG_SWCLK
PA14-BOOT0.Signal=DEBUG_SWCLK
PA2.GPIO_Label=VCP_USART2_TX
PA2.Signal=USART2_TX
PA3.GPIO_Label=VCP_USART2_RX
PA3.Signal=USART2_RX
PA4.GPIO_Label=FAN_PWM
PA4.Signal=S_TIM14_CH1
PA6.GPIO_Label=SERVO_PWM
PA6.Signal=S_TIM3_CH1
PA7.GPIO_Label=TILT_SERVO_PWM
PA7.Signal=S_TIM3_CH2
PA8.GPIO_Label=RIGHT_ARM_PAN_PWM
PA8.Signal=S_TIM1_CH1
PA9.GPIO_Label=RIGHT_ARM_TILT_PWM
PA9.Signal=S_TIM1_CH2
PB0.GPIO_Label=LEFT_ARM_PAN_PWM
PB0.Signal=S_TIM3_CH3
PB1.GPIO_Label=LEFT_ARM_TILT_PWM
PB1.Signal=S_TIM3_CH4
