Sijankhadk65/orio_dev/orio-jetson/orio/llm.py

"""LLM operator brain — a thin conversational wrapper over a chat model.

Holds the rolling chat history (seeded with the scope-limiting system prompt),
streams assistant replies, and executes any tool calls the model makes (see
tools.py). This is the cognition layer: it decides *what* to do and says it in
words. It still never touches hardware itself — the drive tools it can now call
go through body.py, which owns the boards.

The system prompt is finished here rather than in config, because the half of
it about moving depends on whether the drive tools actually bound this run.

The backend is pluggable (config.LLM_PROVIDER): "anthropic" (Claude, cloud) or
"ollama" (a local model). Provider-specific imports are local to _build_llm so
picking one never requires the other's package to be installed/working.
"""

from __future__ import annotations

from collections.abc import Iterator

from langchain_core.messages import AIMessage, BaseMessage, HumanMessage, SystemMessage, ToolMessage

from . import config
from .tools import DRIVE_TOOL_NAMES, get_tools

# Guard against a runaway tool-call loop (a confused model calling tools
# forever without ever producing a final answer).
_MAX_TOOL_HOPS = 3


class LLMUnavailable(RuntimeError):
    """Raised when the configured chat model/provider isn't usable."""


def _content_text(content: str | list) -> str:
    """Normalize a chunk's `.content` to plain text.

    ChatOllama streams `.content` as a plain string, but ChatAnthropic streams
    it as a list of content blocks (e.g. `[{"type": "text", "text": "...", ...}]`)
    — join just the text blocks so both providers yield the same shape here.
    """
    if isinstance(content, str):
        return content
    parts = []
    for block in content:
        if isinstance(block, str):
            parts.append(block)
        elif isinstance(block, dict) and block.get("type") == "text":
            parts.append(block.get("text", ""))
    return "".join(parts)


def _build_llm(provider: str, model: str, host: str | None):
    if provider == "anthropic":
        from langchain_anthropic import ChatAnthropic

        return ChatAnthropic(
            model=model, api_key=config.ANTHROPIC_API_KEY, temperature=config.LLM_TEMPERATURE
        )

    from langchain_ollama import ChatOllama

    return ChatOllama(model=model, base_url=host, temperature=config.LLM_TEMPERATURE)


class Conversation:
    """A single ongoing conversation with the configured chat model."""

    def __init__(
        self,
        model: str = config.LLM_MODEL,
        system_prompt: str = config.SYSTEM_PROMPT,
        host: str | None = config.OLLAMA_HOST,
        provider: str = config.LLM_PROVIDER,
    ) -> None:
        self.model = model
        self.provider = provider
        self._host = host
        self._tools = get_tools()
        self._tools_by_name = {t.name: t for t in self._tools}

        llm = _build_llm(provider, model, host)
        self._llm = llm.bind_tools(self._tools) if self._tools else llm

        # What Orio says about moving is taken from the tools it really has, not
        # from config: a drivetrain that failed to open would otherwise leave it
        # promising to drive and then silently doing nothing.
        can_drive = bool(DRIVE_TOOL_NAMES & set(self._tools_by_name))
        self._system = SystemMessage(
            system_prompt + (config.DRIVE_PROMPT if can_drive else config.NO_DRIVE_PROMPT)
        )
        self._history: list[BaseMessage] = []

    def preflight(self) -> None:
        """Check the configured provider is actually usable; raise a helpful error."""
        if self.provider == "anthropic":
            if not config.ANTHROPIC_API_KEY:
                raise LLMUnavailable(
                    "ANTHROPIC_API_KEY is not set. Add it to .env (see .env.example)."
                )
            return

        import ollama

        client = ollama.Client(host=self._host) if self._host else ollama.Client()
        try:
            available = {m.model for m in client.list().models}
        except Exception as exc:  # connection refused, etc.
            raise LLMUnavailable(
                "Cannot reach the Ollama daemon. Start it with `ollama serve` "
                "(or `systemctl start ollama`)."
            ) from exc

        # Ollama reports names with the tag (e.g. "llama3.2:3b"); accept a bare
        # match on the repository part too ("llama3.2").
        if self.model not in available and not any(
            m.split(":", 1)[0] == self.model.split(":", 1)[0] for m in available
        ):
            raise LLMUnavailable(
                f"Model '{self.model}' is not pulled. Run `ollama pull {self.model}`."
            )

    def _messages(self) -> list[BaseMessage]:
        return [self._system, *self._history]

    def _trim(self) -> None:
        """Keep history bounded (system prompt is separate and always kept)."""
        max_msgs = config.MAX_HISTORY_TURNS * 2  # user+assistant per turn
        if len(self._history) > max_msgs:
            self._history = self._history[-max_msgs:]

    def _run_tool(self, call: dict) -> str:
        fn = self._tools_by_name.get(call["name"])
        if fn is None:
            return f"error: unknown tool {call['name']!r}"
        try:
            return str(fn.invoke(call["args"]))
        except Exception as exc:  # a broken tool must not crash the turn
            return f"error running {call['name']}: {exc}"

    def send(self, user_text: str) -> Iterator[str]:
        """Send a user turn and yield the assistant reply token-by-token.

        If the model calls a tool, it's executed locally and the result is
        fed back for a follow-up (streamed) reply — invisible to the caller
        beyond a short pause; only the final natural-language text is yielded.
        The full reply is appended to history once streaming completes.
        """
        self._history.append(HumanMessage(user_text))
        yield from self._respond()

    def _respond(self, depth: int = 0) -> Iterator[str]:
        full = None
        parts: list[str] = []
        for chunk in self._llm.stream(self._messages()):
            full = chunk if full is None else full + chunk
            text = _content_text(chunk.content)
            if text:
                parts.append(text)
                yield text

        if full is None:
            return

        if full.tool_calls and depth < _MAX_TOOL_HOPS:
            self._history.append(full)
            for call in full.tool_calls:
                result = self._run_tool(call)
                self._history.append(ToolMessage(content=result, tool_call_id=call["id"]))
            yield from self._respond(depth + 1)
            return

        self._history.append(AIMessage("".join(parts)))
        self._trim()
