Sijankhadk65/orio_dev/(commit log)

2026-06-24 Add orio-jetson: LLM operator layer (voice → LLM → speech)
    On-Jetson conversational layer for Orio. Mic input via arecord + RMS VAD,
    faster-whisper ASR, local LLM over Ollama (scope-limited system prompt),
    Piper TTS output. Semantic tool calls (drive_to, etc.) come later.
2026-06-24 Document monorepo layout in root README
    Describe the two-tier split (orio-jetson brain / orio-stm32 controller),
    the rationale for keeping both in one repo, and per-subproject conventions.
2026-06-25 Fix mic capture spinning forever when PipeWire holds the device
    Default MIC_DEVICE was the direct-hardware path plughw:CARD=Device,DEV=0,
    which fails with "Device or resource busy" when PipeWire already holds the
    USB mic open. arecord then produced no audio, every frame read short, and
    listen() couldn't tell that apart from silence — so it looped on
    "listening…" forever, emitting numpy "Mean of empty slice" warnings.
    - config: default MIC_DEVICE to "pipewire" so we capture through the sound
    server and share the mic instead of grabbing the raw device. Override
    with ORIO_MIC_DEVICE for a headless/no-sound-server box.
    - asr.listen(): if capture yields nothing AND arecord exited with an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
    [asr.py, config.py]
2026-06-25 Add operator FSM and "Hey Orio" wake word
    Introduce a single source of truth for what Orio is doing and gate the voice
    conversation behind a wake word.
    FSM (orio/fsm.py):
    - States ASLEEP / IDLE / LISTENING / THINKING / SPEAKING / ERROR with an
    explicit, validated transition table (illegal jumps raise instead of
    silently passing). Thread-safe, with a subscribe() observer hook so future
    subsystems (eyes, LEDs) react to transitions instead of being wired into the
    loop. ASLEEP is the wake-gated resting state; IDLE rests text/always-on mode.
    Wake word (orio/wake.py, Whisper-match):
    - Reuse the loaded Whisper ASR: transcribe each phrase and check it for a wake
    phrase, so no extra model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
    [asr.py, config.py, conversation.py, fsm.py, wake.py]
2026-06-25 Add animated eyes face driven by the operator FSM
    orio/eyes.py: EyesController subscribes to the FSM and maps each State to a
    pre-baked Lottie clip, rasterized on the CPU via rlottie and blitted with
    pygame on a background render thread so the always-on face never contends with
    the GPU and never freezes while the main loop blocks on STT/LLM/TTS.
    - conversation.py: _start_eyes() builds/starts the face if enabled, with the
    import kept local so text/headless runs never pull in pygame/rlottie; any
    display/dep failure disables the face instead of breaking the loop.
    - config.py: ORIO_EYES* knobs (enable, fullscreen, size, fps, debug, clips dir).
    - assets/eyes/: placeholder per-state Lottie cl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
    [config.py, conversation.py, eyes.py]
2026-06-25 Add dedicated openWakeWord wake engine to fix spotty "Hey Orio"
    The Whisper-match wake gate is spotty: Whisper is built for sentences, "Orio"
    is out-of-vocabulary, and short-utterance endpointing is unreliable. Add a
    purpose-built keyword spotter behind the same wake-gate seam.
    - orio/wake_oww.py: OpenWakeWord engine — streams 80ms mic chunks through a
    CPU/ONNX hotword model (torch-free, off the GPU). Runs no Whisper while
    asleep; Whisper handles ASR only once awake.
    - orio/wake.py: extract WhisperWaker wrapping the matcher + ASR so both engines
    share one interface (label + await_wake()); WakeWord stays a pure string brain.
    - conversation.py: _make_waker() picks the engine via ORIO_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
    [config.py, conversation.py, wake.py, wake_oww.py]
2026-06-25 Add off-device "Hey Orio" wake-word training script
    openWakeWord's trainer requires PyTorch, which we keep off the robot, so
    training runs on a separate powerful machine and only the exported .onnx ships
    to the Jetson (train heavy off-device, run lean on-device).
    - tools/train_orio_wakeword.py: launcher that scaffolds an annotated openWakeWord
    training config and drives the three official phases (generate synthetic clips
    → augment → train + export), with a preflight that fails clearly if the torch
    training env isn't set up. Not part of the robot runtime.
    - models/ + .gitignore: home for the trained model; commits *.onnx so a clone
    carries it onto the Jetson, ignores large traini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
2026-06-25 Move wake-word training into its own monorepo component
    Fully isolate PyTorch from the robot package: training moves out of
    orio-jetson/tools/ into a new top-level wakeword-training/ component with its
    own environment (requirements.txt) and README. The Jetson install stays
    torch-free; only the exported hey_orio.onnx ships to orio-jetson/models/.
    - wakeword-training/: train_orio_wakeword.py (moved, paths updated), README,
    requirements (torch + training stack), .gitignore for venv/datasets/output.
    - orio-jetson/docs/wakeword_engine.md: point training steps at ../wakeword-training.
    - README.md: add wakeword-training/ to the monorepo layout.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
2026-08-03 STM feature for UART communication added
2026-08-03 Restore root README.md accidentally deleted in dbfead7
    The monorepo README (architecture, layout) was dropped as a side effect
    of the STM32 UART feature commit; restoring it so this branch merges
    cleanly into develop.
2026-08-03 Add Windows support: cross-platform audio + ElevenLabs TTS
    Replace the Linux-only arecord/aplay subprocess calls with sounddevice
    (PortAudio) for mic capture and speaker playback, so the operator layer
    runs on Windows (STM32 dev box) as well as the Jetson. Also swaps Piper
    for ElevenLabs cloud TTS, with the key loaded from a gitignored .env.
    - orio/audio_input.py: new MicStream, shared by asr.py and wake_oww.py
    - orio/tts.py: PiperTTS removed, ElevenLabsTTS added, playback via sounddevice
    - orio/config.py: MIC_DEVICE/SPEAKER_DEVICE resolve to sounddevice device
    index/name instead of ALSA-specific strings; ElevenLabs config; loads .env
    - pyproject.toml: +sounddevice, +elevenlabs, +python-d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
    [asr.py, audio_input.py, config.py, tts.py, wake_oww.py]
2026-08-03 Add settings.json as an alternative to env vars
    PowerShell silently swallows bash's inline VAR=x command syntax as an
    ignored positional argument instead of erroring, so ORIO_* overrides would
    appear to do nothing on Windows with no indication why. config.py now
    resolves every tunable (except ELEVENLABS_API_KEY, which stays .env-only)
    through shell env var > settings.json > hardcoded default, so settings can
    be set once in a gitignored settings.json instead of re-typed per shell.
    Also expands the README: run recipes in both bash and PowerShell, the eyes
    demo/config, and a full configuration reference cross-checked against
    config.py.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
    [config.py]
2026-08-03 Smooth the eyes' state transitions with an eased blink
    rlottie has no live blending between clips, so a state change was a hard
    cut. Mask it with a blink instead: eyelids sweep shut (eased with
    smoothstep, not constant-speed), the clip swaps while hidden, then they
    sweep back open. Drawn as a pygame overlay independent of clip content, so
    it keeps working once designer art replaces the placeholders. Retargeting
    mid-close just redirects to the newer state instead of restarting.
    New ORIO_EYES_TRANSITION_MS (default 400ms — short enough to feel snappy,
    long enough to give the eased sweep room to read as smooth at 30fps).
    [config.py, conversation.py, eyes.py]
2026-08-03 Add vision object-detection tool via LangChain + Ollama tool-calling
    Orio's first real LLM tool: "what do you see" now captures a camera frame,
    runs it through a YOLO nano model, and answers from the actual result
    instead of guessing. Read-only by design — it reports what's visible, it
    never actuates anything.
    - orio/vision.py: ObjectDetector (lazy camera+model, thread-safe via a
    lock) and VisionDebugWindow, a live camera+detection-box preview window
    for debugging (ORIO_VISION_DEBUG=1), sharing the same detector/lock as
    the LLM's tool calls so the two never fight over the camera
    - orio/tools.py: the what_do_you_see @tool; degrades to no tools on
    missing camera/deps rather than bre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
    [config.py, conversation.py, llm.py, tools.py, vision.py]
2026-08-03 Fix openWakeWord label to reflect the loaded model, not WAKE_PHRASES
    label was hardcoded to WAKE_PHRASES[0] ("Hey Orio"), which this engine
    doesn't use at all — it only reacts to whatever model ORIO_WAKE_OWW_MODEL
    loads. Switching to a built-in model like "hey_jarvis" left the on-screen
    prompt still saying "Hey Orio" while the engine only fired on "Hey Jarvis",
    which looks like the engine is broken rather than just mislabeled.
    Now derives the label from the loaded model name (a bare keyword name is a
    built-in model whose name doubles as the phrase); a custom trained model's
    filename isn't a readable phrase, so that case still falls back to
    WAKE_PHRASES as a best-effort label.
    Co-Authored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
    [wake_oww.py]
2026-08-03 Fix dropped speech onset and a stray console artifact
    asr.py: noise-floor calibration read ~480ms of mic audio and discarded it
    before the VAD started watching for speech. Talking within that window —
    plausible right after a wake word with no pause — silently dropped those
    words before capture logic ever saw them ("how are you?" -> "are you?").
    Calibration frames now seed the pre-roll buffer instead of being thrown
    away, so onset speech during calibration is preserved.
    conversation.py: a bare "\r" before "you › {text}" only overwrites the
    start of the previous "\U0001f3a4 listening…" line, leaving its tail
    visible whenever the new text is shorter (e.g. "Bye.ng…"). Clear the
    line f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
    [asr.py, conversation.py]
2026-08-03 Fix Linux/Jetson audio setup: PortAudio dep, dead default mic/speaker
    Three real setup failures hit when actually running the Windows-ported
    audio stack on a Jetson for the first time:
    - sounddevice needs the system libportaudio2 on Linux (the wheel bundles
    it for Windows/macOS but dynamically loads it on Linux) — was an
    undocumented dependency, crashing voice mode with a raw OSError
    traceback. Documented in the README setup steps; conversation.py now
    catches it and prints an actionable install command instead.
    - PortAudio's raw "default" input silently resolved to a dead stream on
    this Jetson (measured: pure silence) while a device literally named
    "pipewire" correctly reache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
    [audio_input.py, config.py, conversation.py, tts.py]
2026-08-04 Add local RAG knowledge base + Orio persona; move ASR/LLM to cloud + pluggable providers
    Knowledge base:
    - orio/knowledge.py: per-profile RAG store (sqlite-vec + local ONNX
    embeddings via fastembed/BGE) so a deployment's knowledge (Orio's own
    identity, or a venue like a grocery store) is swappable via
    ORIO_KB_PROFILE without code changes. Default "orio" profile self-seeds.
    - orio/kb_ingest.py: CLI to ingest .md/.txt documents into a profile.
    - New search_knowledge_base tool wired into tools.py/config.py alongside
    the existing vision tool.
    - grocery-store.md / grocery-inventory.md: sample venue content to ingest.
    Persona:
    - SYSTEM_PROMPT now defines Orio's quirky/endearing personalit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
    [asr.py, config.py, conversation.py, kb_ingest.py, knowledge.py, llm.py, tools.py, wake.py]
2026-08-04 Replace rlottie eye renderer with procedural pygame drawing
    rlottie in this environment renders keyframed Scale-type properties (layer
    scale, group transform, or a shape's own declared size) correctly only on
    their first frame, and separately breaks a layer's Position the moment that
    same layer also carries an animated Path - confirmed by isolated repro, not
    a config issue. Since the eye art is just two parametric rounded rects, swap
    the Lottie/rlottie pipeline for a small per-state JSON keyframe table that
    orio/eyes.py interpolates and draws directly with pygame.draw.rect each
    frame (including the mirrored static rotation for slant/angry/sleepy looks).
    Also adds a blocky pixelation post-pro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
    [config.py, conversation.py, eyes.py]
2026-08-04 Port reference canvas engine 1:1 for pixel-accurate eyes
    The keyframe-JSON approximation only sampled the design's motion; the real
    thing (orio-eyes-standalone.html) is a closed-form function of time and
    state. Port that engine directly into orio/eyes.py (_Face): same per-state
    target formulas, same hard-edged scanline blob renderer, same blink/wink/
    mic/glitch behavior, drawn at the reference's native 128x72 with no
    anti-aliasing and scaled up with nearest-neighbor for genuinely crisp
    pixels (drawing at full res and downsampling, as before, blurred the edges).
    State changes now continuously ease into their new target exactly like the
    reference, so the old blink-transition-mask system is no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
    [config.py, conversation.py, eyes.py]
2026-08-04 Add CRT scanline and RGB fringe overlays to the eyes
    Ports the two remaining flat CSS overlay layers from
    orio-eyes-standalone.html: a drifting horizontal scanline band (_build_
    scanlines/_draw_scanlines, matching scanDrift) and a static vertical RGB
    fringe grid (_build_fringe). Both draw over the upscaled face at display
    resolution so they stay crisp regardless of the native 128x72 canvas size.
    Vignette and flicker are still deferred.
    [eyes.py]
2026-08-16 Basic motor & ARGB fans functions added
2026-08-16 Basic Servo joint movement neck/left-arm/right-arm added
2026-08-16 Add left-arm and right-arm servo joints
    Left arm rides TIM3's previously-unused CH3/CH4 (PB0/PB1); right arm
    gets a new TIM1 instance (PA8/PA9), both at the same 50 Hz PWM config
    as the neck servos. TIM14 (fan) and TIM16 (ARGB) were regenerated
    alongside these via CubeMX after they'd drifted out of the .ioc.
    [main.c, main.h, orio-stm-motion.ioc, protocol.c]
2026-08-23 Give each drivetrain FSESC its own dedicated UART
    Removes the USART1 mux (usart_mux.c/.h) that time-shared one UART
    between both FSESCs, and instead wires the left FSESC to USART1 and
    the right FSESC to USART3 directly. Vesc_t now holds a UART handle
    instead of a mux side, and wheel.c/protocol.c use a local
    WheelSide_t enum in place of the old DriveSide_t.
2026-08-23 Add per-joint servo angle limits, fix TIM3/DMA config bugs
    Splits the servo model's fixed pulse-width calibration from a new
    per-joint commandable angle limit (ServoAxisLimit_t / kJointLimits[]
    in servo_joint.c), since a joint's bracket can hit a mechanical stop
    before the servo's own electrical range. All three joints currently
    restrict tilt to 30-90 deg instead of the servo's full 0-180 deg
    travel; CMD_MOVE_JOINT_TO and CMD_RESET_JOINTS now validate/clamp
    against these live limits instead of a single hardcoded range.
    Also fixes two config bugs found along the way: TIM3 was never
    configuring PWM channels 1/2 (only channel 3), and the TIM16 DMA
    channel had its direction and data alignment b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
    [main.c, orio-stm-motion.ioc, protocol.c, protocol.h, servo_joint.c, servo_joint.h]
2026-08-23 Retarget drivetrain controller to STM32L152RE, fix broken hybrid regeneration
    The previous commit (f6d756d) retargeted the .ioc to the L152RE but only
    hand-edited the source files -- CubeMX's in-place regeneration across MCU
    families left a broken hybrid project: no L1 startup file or linker script
    was generated, a stale system_stm32c0xx.c sat next to the new
    system_stm32l1xx.c, and .cproject/.project never got updated off the old
    STM32C031 device/include-paths/CPU flags. It didn't build.
    Fixed by generating a clean project from scratch via the board selector
    (proper startup file, linker scripts, and toolchain settings for
    STM32L152RET6 / NUCLEO-L152RE) and carrying the custom protocol.c/ve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
    [main.c, main.h, move_wheel.py, orio-stm-drivetrain.ioc, proto_client.py, protocol.h, stop_all.py]
2026-09-05 Fix CSI camera returning solid green frames
    cv2.VideoCapture(index) cannot capture the IMX219. The sensor exposes a
    single V4L2 format, RG10 (10-bit packed Bayer), and only the Jetson ISP
    debayers it. OpenCV hands back a constant buffer and still reports success:
    read() returns True, the array is correctly shaped (2464, 3280, 3), and every
    pixel is [0 154 0]. Nothing raises, so this read downstream as "the camera
    works but YOLO never detects anything", and ORIO_VISION_DEBUG=1 showed a plain
    green window.
    Capture now goes through the ISP via an nvarguscamerasrc GStreamer pipeline,
    which needs an OpenCV built with GStreamer. PyPI's opencv-python is not, and
    JetPack's system build is tied to t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
    [config.py, vision.py]
2026-09-05 Add stereo depth and obstacle detection
    Depth from the IMX219-83's two sensors, reduced to the nearest obstacle in
    each of 7 sectors across the field of view. Perception only: ObstacleMap
    carries distances and clearances, never velocities, and this module emits no
    motion and knows nothing about the STM32.
    Four hardware facts are pinned in config rather than rediscovered later. All
    four are silent failures — each one degrades depth without raising anything —
    so each was measured on the bench and carries its numbers in the comments:
    * The eye/sensor mapping is a cabling fact, not a constant. Argus sensor 0 is
    currently the left eye (measured dx = +86 px at 640x360, 424 ORB inliers).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
    [config.py, stereo.py]
2026-09-06 Fix stereo depth reading unknown everywhere with a calibration loaded
    The first saved calibration exposed a latent 1000x unit error. calibrate_stereo
    builds its board model in millimetres, deliberately, so the solved baseline is
    comparable to the published 60 mm — which makes T, and therefore P2[0,3], mm.
    _load_calibration took P2[0,3]/P2[0,0] straight into _baseline_m.
    The symptom was not "distances look wrong": every depth landed between 459 m and
    22,058 m, all of it past STEREO_MAX_RANGE_M, so the range gate NaN'd the whole
    map and stereo_debug showed unknown everywhere. stereoRectify now gets T/1000.
    Four things fell out of fixing it.
    * Sector angles came from a hardcoded 73 deg whi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
    [config.py, stereo.py]
2026-09-06 Recover VESC parser from a desynced UART stream
    Vesc_PollValues() bailed out the moment the first byte read wasn't
    VESC_PKT_START, leaving the parser sitting mid-frame. One glitched or
    leftover byte on the wire therefore desynced every subsequent poll --
    each failed attempt consumed one more byte of a real frame and no poll
    could ever line back up on a start byte again.
    Replaces that single-byte check with a bounded byte-by-byte scan for
    VESC_PKT_START (VESC_RESYNC_MAX_ATTEMPTS = 32), so a poll walks past
    noise to the next real frame instead of giving up. The bound keeps a
    dead link or a continuously noisy one from spinning here: a read that
    times out returns immediately, and 32 non-start b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
    [move_both.py, move_wheel.py, stop_all.py, vesc.c]
2026-09-06 Put servo angles back on the vendor scale, ramp joint moves
    servo_joint.h had re-zeroed both axes on mid-travel (pan -135..135,
    tilt -90..90), so every angle in this firmware differed from every
    angle in the vendor's datasheet and example code by a constant. The
    per-joint limit table was written in vendor numbers but read as
    re-zeroed ones: the neck's tilt window landed at 175..185 deg instead
    of a band around level, driving the head against the servo's top end
    stop, where it stalled. A previous attempt at that symptom stretched
    tilt's calibration to 2556 us / +95.00 deg, which is travel past the
    servo's rated range, not rated travel that had been left out.
    Both servo models are now calibra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
    [main.c, move_joint.py, proto_client.py, protocol.c, protocol.h, servo_joint.c, servo_joint.h, sweep_axis.py]
2026-09-06 Stop latching stale wheel speeds through an e-stop clear; add WASD teleop
    Wheel_Stop() zeroed the ESC outputs but left s_commanded_permille
    untouched, so a heartbeat clearing the e-stop called Wheel_Resume() and
    immediately re-applied whatever speed was commanded before the stop --
    visible as "the wheels execute the previous command, then the current
    one" when running the bench-test scripts back to back. Worse, it meant a
    real heartbeat lapse mid-drive would make the robot lurch back into its
    last motion the moment the Jetson reconnected, before sending any new
    command. Wheel_Stop() now clears the latched speeds too, so resuming from
    any stop (CMD_STOP or the watchdog) comes back stopped and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
2026-09-06 Make teleop_wasd.py cross-platform (Windows + Linux/Jetson)
    Swaps the msvcrt-only keyboard polling for a small KeyReader abstraction:
    msvcrt on Windows, termios+select (cbreak mode, stdlib only) on POSIX.
    Same non-blocking single-keystroke behavior and control scheme either
    way, so it now runs unchanged on the Jetson against /dev/ttyACM0.
    cbreak mode keeps ISIG enabled, so Ctrl+C still raises KeyboardInterrupt
    and goes through the same stop-and-cleanup path as pressing q; terminal
    settings are restored in KeyReader.__exit__ regardless of how the loop
    exits.
    [teleop_wasd.py]
2026-09-07 Keep re-sending duty so the FSESC's own timeout doesn't cut the motor
    Vesc_SetDuty() only ever fired when a *new* CMD_SET_DRIVE value arrived.
    That was fine for the old hold-to-move teleop (which resent on every OS
    key-repeat event) and for the one-shot bench scripts (short enough to
    finish before it mattered), but once the teleop switched to latched
    directions -- press once, keeps going -- a held direction stopped getting
    re-sent at all. Each FSESC has its own UART command timeout (~1000ms,
    independent of this board's Jetson-link heartbeat watchdog), so the motor
    would cut itself off about a second in regardless of anything the STM32 or
    Jetson were doing, and the teleop's own send-on-change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
    [main.c, teleop_wasd.py, vesc.c, wheel.c, wheel.h]
2026-09-07 Stop tracking build output, IDE workspace metadata, and Python cache
    Adds .gitignore at the repo root (.metadata/ -- the STM32CubeIDE
    workspace's own state: indexer databases, build logs, per-session history
    snapshots, none of it meaningful to another checkout) and one per STM32
    subproject (Debug/, Release/, tools/__pycache__/), matching the
    per-subproject .gitignore convention orio-jetson already uses.
    Untracks what those patterns now cover -- 316 files across .metadata/,
    orio-stm-motion/Debug/, orio-stm-drivetrain/Debug/, and both tools/
    directories' __pycache__/. Nothing deleted from disk, git just stops
    following them; they'll keep regenerating locally exactly as before.
    Co-Authored-By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
2026-09-07 Remove unused uv-init scaffold from both tools/ directories
    pyproject.toml, uv.lock, .python-version, README.md, and src/tools/ were
    left over from a stray "uv init" in each tools/ directory -- default
    boilerplate (src/tools/__init__.py was still the "Hello from tools!"
    placeholder) never wired to anything. The actual scripts (move_wheel.py,
    teleop_wasd.py, move_joint.py, etc.) declare their own dependencies via
    PEP 723 inline metadata and don't need a project file at all; `uv run`
    resolves and installs pyserial from that alone, confirmed working with
    this scaffold gone.
2026-09-07 Add a Jetson-side drivetrain link and stereo-guarded teleop
    Joins the two halves that each deliberately stopped at the same seam:
    stereo.py reports what is in the way and refuses to decide anything about
    motion, and the STM32 accepts wheel duties and knows nothing about cameras.
    Nothing in this repo spoke the drivetrain protocol until now.
    orio/drivetrain.py ports the wire format from the drivetrain repo's
    tools/proto_client.py (a separate repository, so it cannot be imported).
    Three firmware behaviours shape it:
    * Only CMD_HEARTBEAT touches the watchdog -- CMD_SET_DRIVE does not -- so a
    caller that drives continuously and never pings is still e-stopped after
    500 ms. Heartbeats therefo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
2026-09-07 Commit the stereo calibration so a clone carries it
    models/.gitignore is a catch-all `*` written for wake-word models, allowing
    only .onnx/.tflite through; the calibration .npz fell past it incidentally
    rather than by decision. The reasoning already written in that file applies
    here unchanged -- commit the artefact so a git clone onto the Jetson carries
    it, rather than reproducing it on-device -- and reproducing this one means
    fifteen minutes of waving a checkerboard at the robot.
    With it in place depth reports calibrated=True and derives its own HFOV from
    the rectified focal length: 73.1 deg, against the 73.0 deg the datasheet
    gives for the binned mode. Agreement that close is a good sign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
2026-09-07 Steer around obstacles instead of stopping in front of them
    The guard vetoed; this plans. Tap W and the robot cruises, picks a heading
    from the sector map, works around what is in its way and carries on. The
    operator still says "go" and "stop"; between those the heading is chosen here.
    Straight on is preferred and only given up when it must be, scored as
    distance minus a penalty for how far off-axis a gap sits, so a marginally
    roomier route 30 degrees away loses to a good-enough one dead ahead. Below
    the stop floor there is no forward component at all: it pivots, exactly the
    floor the stop-only guard enforced.
    Unknown sectors are never steered toward — committing to a heading you cannot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
2026-09-08 Open the drivetrain by a stable name, not /dev/ttyACM0
    Both STM32 boards are now on the Jetson's USB bus, and teleop_guarded
    defaulted to /dev/ttyACM0 — which is currently the *motion* board. The
    number is USB enumeration order, not physical port order: the board on
    hub port 1-2.3 took ACM0 and the one on 1-2.1 took ACM1, purely because
    the first was present at boot, and that flips on any reboot or hot-plug.
    Running guarded teleop with no --port would therefore have sent
    CMD_SET_DRIVE to the neck/arm board. Both boards share the framing, so
    the frame passes CRC and decodes as valid — the servos act on a wheel
    duty pair and nothing reports an error. Silent mis-actuation, not a
    crash, whi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
    [config.py]
2026-09-08 Confirm each STM32's identity on the wire before arming it
    51fce19 moved the drivetrain onto a udev symlink, which fixes the common
    case but not the failure mode underneath it. A symlink silently matches
    nothing if a board is swapped for one with a different ST-LINK serial, and
    it cannot see drivetrain firmware flashed onto the motion board. Both
    boards share the framing and CRC, so a CMD_SET_DRIVE delivered to the neck
    and arms passes CRC and decodes as a valid frame of the wrong kind: the
    servos slew to whatever a wheel duty pair happens to mean, with nothing on
    the console. Silent mis-actuation again, one layer down. Identity has to be
    answered by the board itself.
    Both firmwares gain CM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
    [drivetrain.py, proto_client.py, protocol.c, protocol.h, test_protocol.py, test_whoami.py]
2026-09-09 Servo motion stablized
2026-09-13 Give Orio a carrier board, generated from its own netlist
    One 19-20 V input, four rails, both Nucleos on Morpho sockets, and every
    servo/fan/ARGB/FSESC connector on a board edge. The 36 V traction domain
    stays off the PCB entirely -- the carrier meets it only at the step-down
    module feeding J1 and at two ESC serial links, which cross a galvanic
    isolation barrier rather than a wire. Bridging that ground with a UART
    return closes a loop around the motor leads, and 115200 baud framing has
    no error recovery beyond a retry.
    The schematic is generated, not drawn. tools/design.py holds the parts and
    nets; tools/generate.py emits the KiCad project from it. Every pin gets a
    wire stub ending in a glo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
    [bom.csv, conv12_5.kicad_sch, conv7v4.kicad_sch, drivetrain.kicad_sch, motion.kicad_sch, orio-carrier.kicad_pcb, orio-carrier.kicad_sch, power.kicad_sch]
2026-09-13 Register the project symbol library so KiCad can open the schematic
    Without a sym-lib-table every `orio-carrier:` lib_id is unresolvable and
    the sheets open as a field of missing-symbol placeholders. ${KIPRJMOD}
    keeps the path relative so it works from any checkout. Footprints come
    from KiCad's global libraries and need no table of their own.
    All 24 referenced symbols now resolve against the 24 the generator emits.
    [generate.py]
2026-09-13 Make every footprint resolve against KiCad's own libraries
    Six of the 28 footprint references were names chosen by inspection that
    don't exist, so "Update PCB from Schematic" would have failed on them.
    Checked against a real KiCad 10 install and fixed:
    L_Bourns-SRN6045TA -> L_Bourns_SRN6045TA (hyphen vs underscore)
    L_Bourns_SRP1265A -> L_Bourns_SRP1245A (same SRP12xx 12.5mm land)
    VQFN-24-1EP_4x4mm... -> HVQFN-24-1EP_4x4mm..._ThermalVias
    SOIC-8-1EP...EP2.29x3.0mm -> ...EP2.29x3mm_ThermalVias
    SolderWirePad_1x02_P5.08mm -> SolderWire-4sqmm_1x02_P12mm (12 AWG, XT60)
    The thermal-via variants are the right call for the LM5145 and both
    TPS54360B stages regar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
    [bom.csv, conv12_5.kicad_sch, conv7v4.kicad_sch, drivetrain.kicad_sch, power.kicad_sch]
